jonsag/ardCurveTracer/Readme.md

# Transistor Curve Tracer

Based on a project I found at [instructables](https://www.instructables.com/Transistor-Curve-Tracer)
