jonsag/ardCurveTracer/KiCad/ardCurvTracer/ardCurvTracer.kicad_pcb

## KiCad design KiCad/ardCurvTracer/ardCurvTracer.kicad_pcb (2023-02-21)

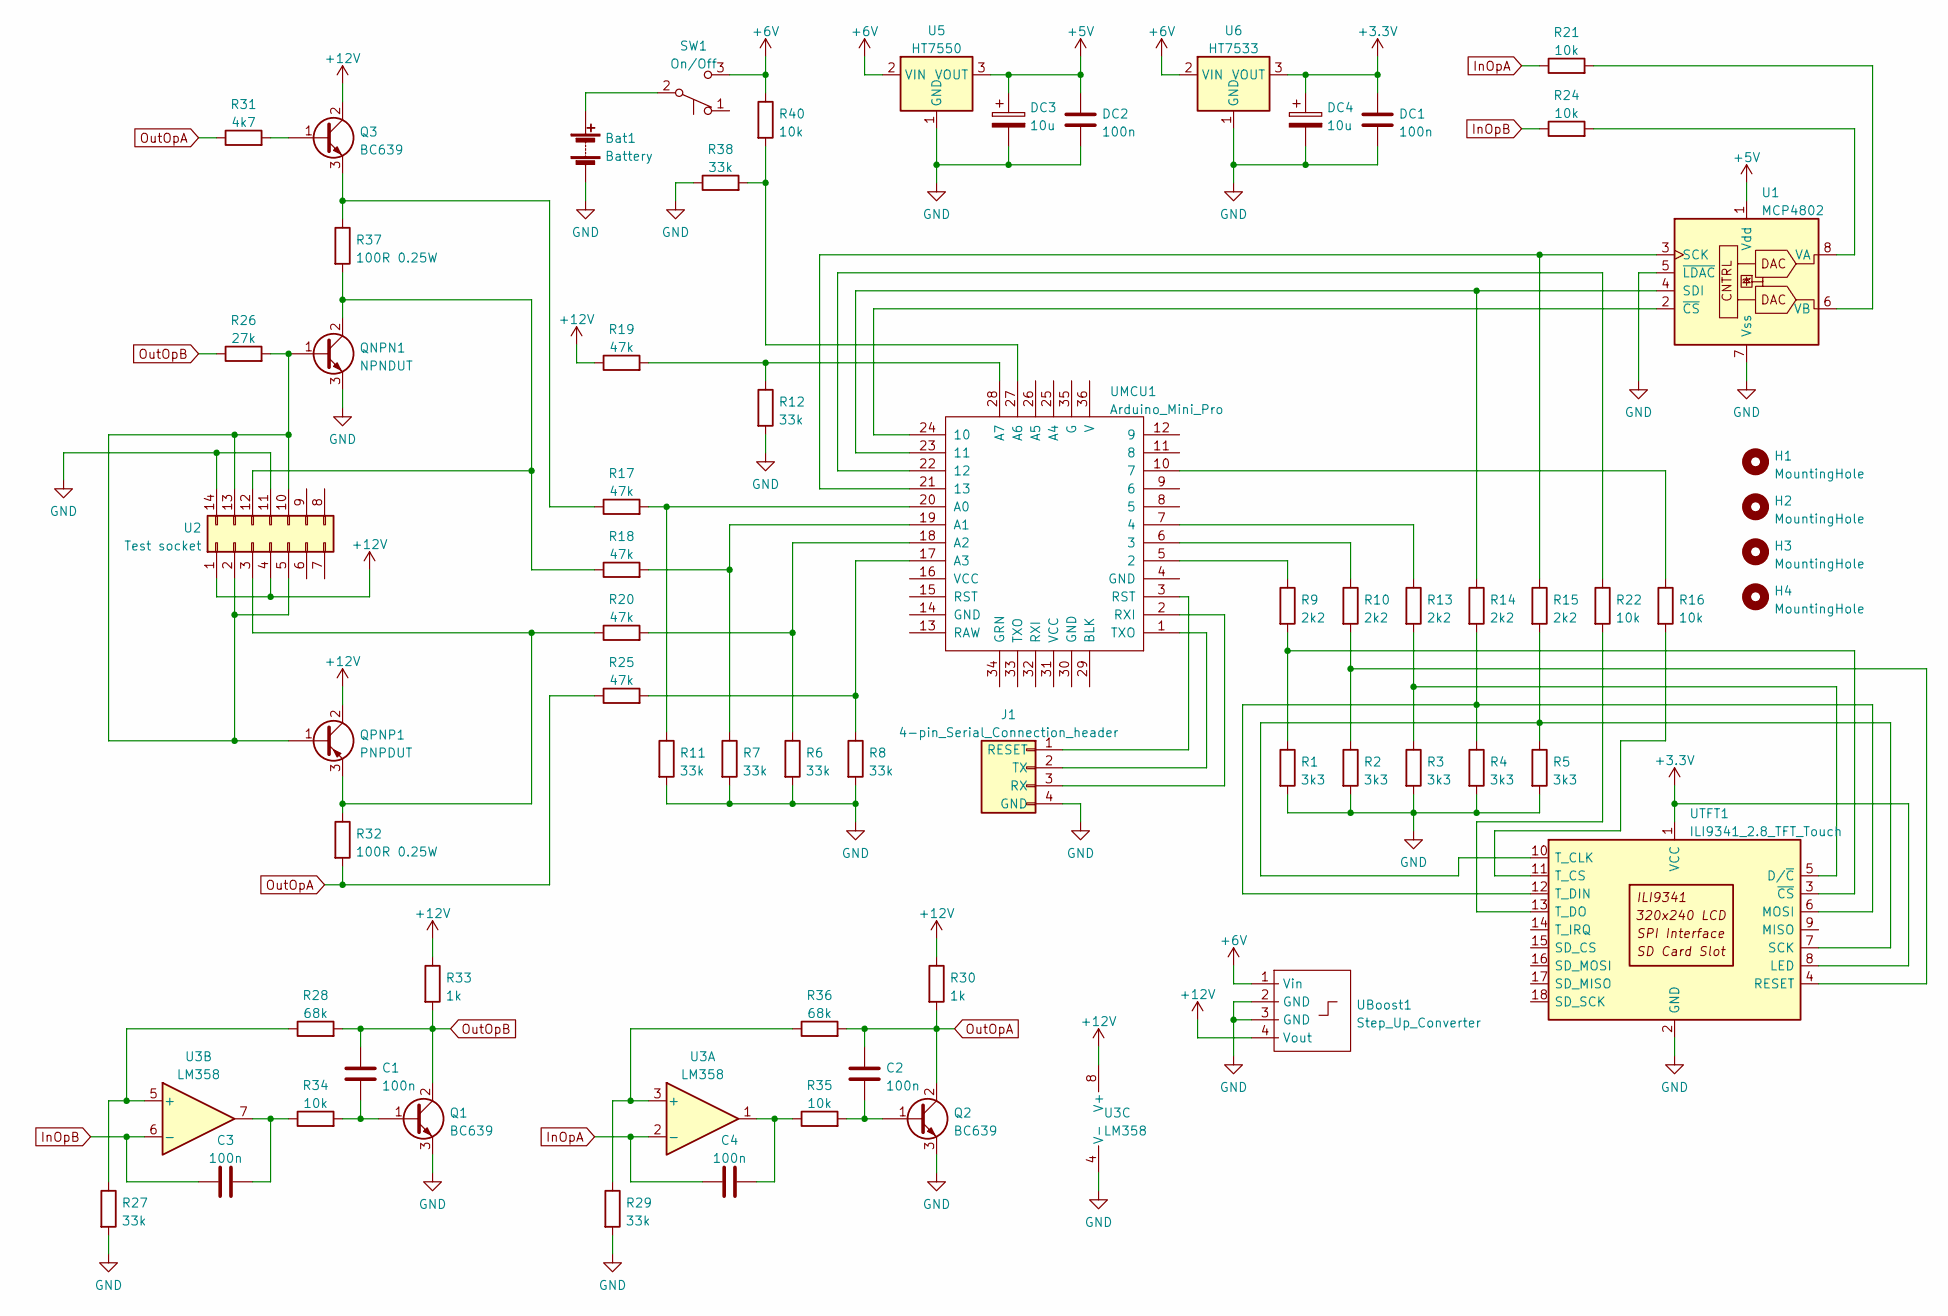
[picture p1: schematic ardCurvTracer.kicad_sch]

Parts:
Bat1: Battery; 2-pin_power_input_header_larger_pads
C1, C2, C3, C4: 100n; C_Disc_D3.0mm_W1.6mm_P2.50mm_larg
DC1, DC2: 100n; C_Disc_D3.0mm_W1.6mm_P2.50mm_larg
DC3, DC4: 10u; CP_Radial_D5.0mm_P2.00mm_larger
H1, H2, H3, H4: MountingHole; MountingHole_3.2mm_M3
J1: 4-pin_Serial_Connection_header; 4-pin Serial Connection header large
Q1, Q2, Q3: BC639; TO-92_Inline_Wide_large
QNPN1: NPNDUT
QPNP1: PNPDUT
R1, R2, R3, R4, R5: 3k3; R_Axial_DIN0207_L6.3mm_D2.5mm_P10.16mm_Horizontal_larger_pa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
R6, R7, R8, R11, R12, R27, R29, R38: 33k; R_Axial_DIN0207_L6.3mm_D2.5mm_P10.16mm_Horizontal_larger_pa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
R9, R10, R13, R14, R15: 2k2; R_Axial_DIN0207_L6.3mm_D2.5mm_P10.16mm_Horizontal_larger_pa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
R16, R21, R22, R24, R34, R35, R40: 10k; R_Axial_DIN0207_L6.3mm_D2.5mm_P10.16mm_Horizontal_larger_pa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
R17, R18, R19, R20, R25: 47k; R_Axial_DIN0207_L6.3mm_D2.5mm_P10.16mm_Horizontal_larger_pa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
R26: 27k; R_Axial_DIN0207_L6.3mm_D2.5mm_P10.16mm_Horizontal_larger_pa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
R28, R36: 68k; R_Axial_DIN0207_L6.3mm_D2.5mm_P10.16mm_Horizontal_larger_pa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
R30, R33: 1k; R_Axial_DIN0207_L6.3mm_D2.5mm_P10.16mm_Horizontal_larger_pa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
R31: 4k7; R_Axial_DIN0207_L6.3mm_D2.5mm_P10.16mm_Horizontal_larger_pa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
R32, R37: 100R 0.25W; R_Axial_DIN0207_L6.3mm_D2.5mm_P10.16mm_Horizontal_larger_pa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
SW1: On/Off; 2-pole switch large
U1: MCP4802; DIP-8_W7.62mm_Socket_w_dip_packet_LongPads
U2: Test socket; ZIF_DIP_Socket-14_W4.3_W5.08_W7.62_W10.16_W10.9_3M_214-3339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
U3: LM358; DIP-8_W7.62mm_Socket_w_dip_packet_LongPads
U5: HT7550; SOT-89-3
U6: HT7533; SOT-89-3
UBoost1: Step_Up_Converter; 6V to 12V Step Up Converter
UMCU1: Arduino_Mini_Pro; Arduino_Pro_Mini_vA_sides_n_A4-A7_large
UTFT1: ILI9341_2.8_TFT_Touch; ILI9341 2.8 TFT Touch large

Connections:
+3V3: DC1.1, DC4.1, U6.3 (VOUT), UTFT1.1 (VCC), UTFT1.8 (LED)
+5V: DC2.1, DC3.1, U1.1 (Vdd), U5.3 (VOUT)
+6V: R40.1, SW1.3 (C), U5.2 (VIN), U6.2 (VIN), UBoost1.1 (Vin)
+12V: Q3.2 (C), QPNP1.2 (C), R19.1, R30.1, R33.1, U2.1, U2.4, U3.8 (V+), UBoost1.4 (Vout)
GND: Bat1.2 (-), DC1.2, DC2.2, DC3.2, DC4.2, J1.4 (GND), Q1.3 (E), Q2.3 (E), QNPN1.3 (E), R1.2, R2.2, R3.2, R4.2, R5.2, R6.2, R7.2, R8.2, R11.2, R12.2, R27.2, R29.2, R38.1, U1.5 (~LDAC), U1.7 (Vss), U2.11, U2.14, U3.4 (V-), U5.1 (GND), U6.1 (GND), UBoost1.2 (GND), UBoost1.3 (GND), UTFT1.2 (GND)
InOpA: C4.1, R21.1, U3.2 (-)
InOpB: C3.1, R24.1, U3.6 (-)
unnamed: Bat1.1 (+), SW1.2 (B)
unnamed: C1.1, Q1.1 (B), R34.2
unnamed: C2.1, Q2.1 (B), R35.2
unnamed: C3.2, R34.1, U3.7
unnamed: C4.2, R35.1, U3.1
unnamed: J1.1 (RESET), UMCU1.3 (RST)
unnamed: J1.2 (TX), UMCU1.1 (TXO)
unnamed: J1.3 (RX), UMCU1.2 (RXI)
unnamed: Q3.1 (B), R31.2
unnamed: Q3.3 (E), R17.1, R37.1
unnamed: QNPN1.1 (B), QPNP1.1 (B), R26.2, U2.2, U2.5, U2.10, U2.13
unnamed: QNPN1.2 (C), R18.1, R37.2, U2.12
unnamed: QPNP1.3 (E), R20.1, R32.1, U2.3
unnamed: R1.1, R9.2, UTFT1.3 (~CS)
unnamed: R9.1, UMCU1.5 (2)
unnamed: R10.1, UMCU1.6 (3)
unnamed: R2.1, R10.2, UTFT1.4 (RESET)
unnamed: R11.1, R17.2, UMCU1.20 (A0)
unnamed: R12.1, R19.2, UMCU1.28 (A7)
unnamed: R13.1, UMCU1.7 (4)
unnamed: R3.1, R13.2, UTFT1.5 (D/~C)
unnamed: R14.1, U1.4 (SDI), UMCU1.23 (11)
unnamed: R4.1, R14.2, UTFT1.6 (MOSI), UTFT1.12 (T_DIN)
unnamed: R15.1, U1.3 (SCK), UMCU1.21 (13)
unnamed: R5.1, R15.2, UTFT1.7 (SCK), UTFT1.10 (T_CLK)
unnamed: R16.1, UMCU1.10 (7)
unnamed: R16.2, UTFT1.11 (T_CS)
unnamed: R7.1, R18.2, UMCU1.19 (A1)
unnamed: R6.1, R20.2, UMCU1.18 (A2)
unnamed: R21.2, U1.6 (VB)
unnamed: R22.1, UMCU1.22 (12)
unnamed: R22.2, UTFT1.13 (T_DO)
unnamed: R24.2, U1.8 (VA)
unnamed: R8.1, R25.2, UMCU1.17 (A3)
unnamed: R27.1, R28.1, U3.5 (+)
unnamed: R29.1, R36.1, U3.3 (+)
unnamed: R38.2, R40.2, UMCU1.27 (A6)
unnamed: U1.2 (~CS), UMCU1.24 (10)
OutOpA: C2.2, Q2.2 (C), R25.1, R30.2, R31.1, R32.2, R36.2
OutOpB: C1.2, Q1.2 (C), R26.1, R28.2, R33.2

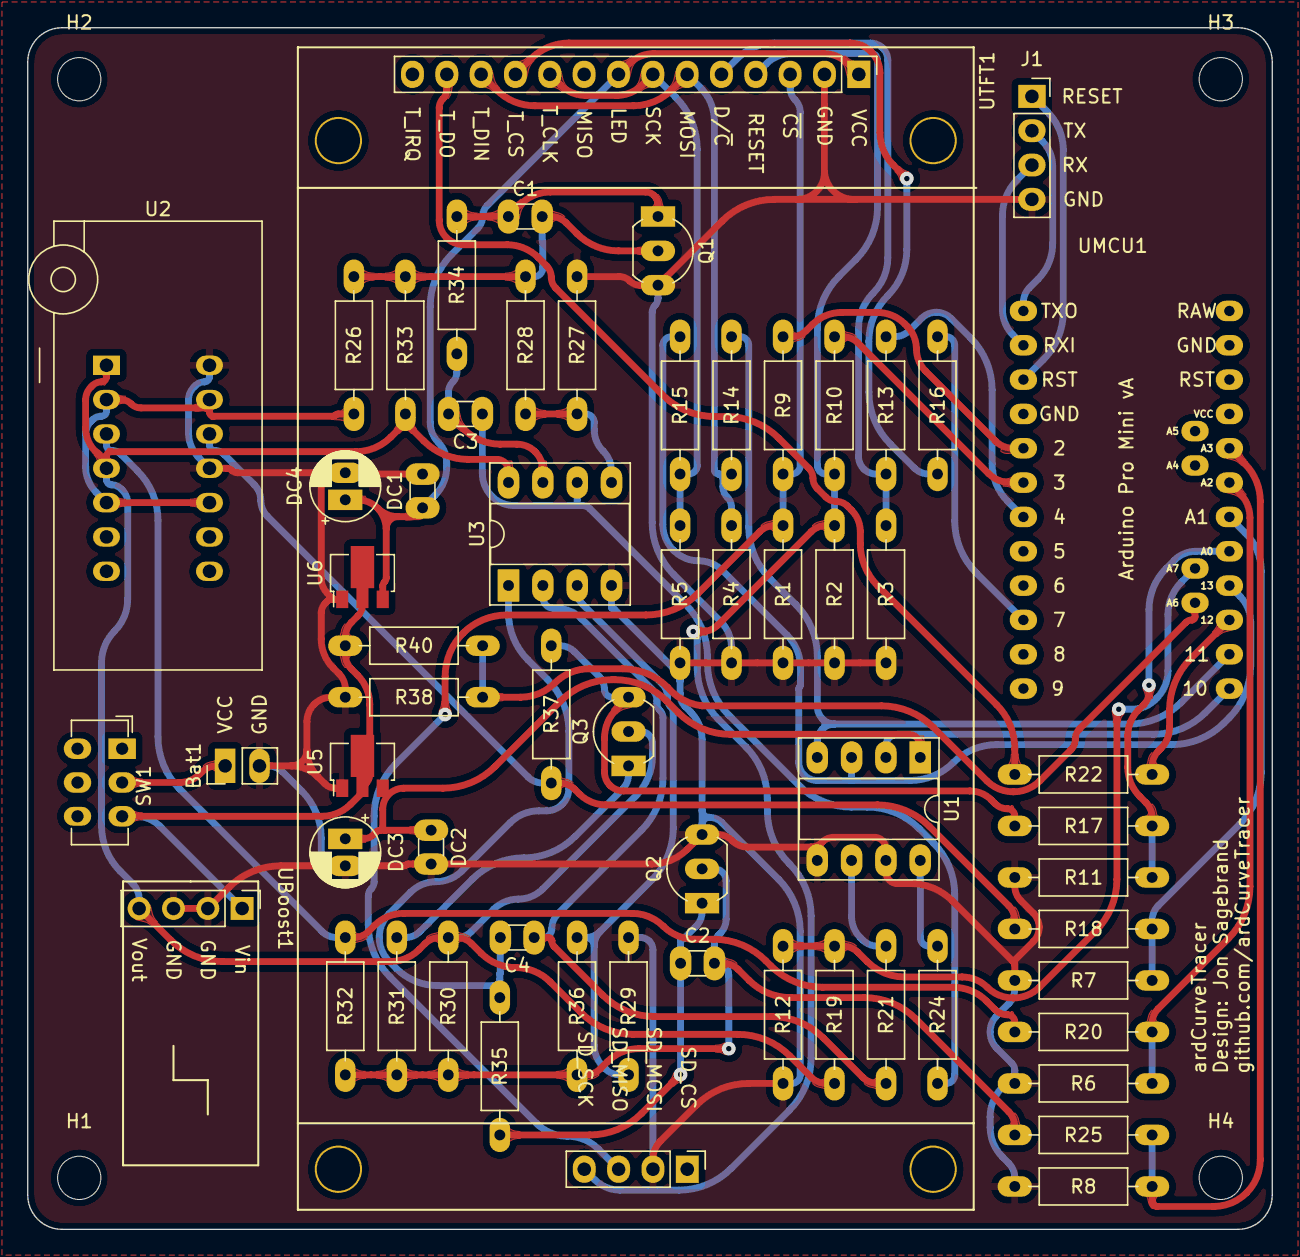
[picture p2: board ardCurvTracer.kicad_pcb from above]

Board: 2 copper layers, 92.1 x 88.9 mm, 64 parts (0 on the bottom side), 47 nets.
